TheCell/Weatherstation/README.md

# Weatherstation
A weather station we design from scratch

For the schema we use Kicad

We meet weekly and we discuss everything and work on the files and ideas. I recap our meetings in form of a blog here: https://blog.thecell.eu/blog/tag/weather/
