TheCell/Weatherstation/_media/Blogposts/WeatherStation_4_FinishingWindprobeSchema.pdf

blog.thecell.eu

## Weather station: Finishing windprobe schema

Name *

### 2 minutes

On 14. December 2019 by TheCell


This Session we finalized the schematics for the windprobe. The Diagram shown is tested in kicad and the electrical connections are all good. We changed how the interruptors are handled and what gets managed by the Raspberry. The Signal Management works over a I²C bus now.

Weather station: Finishing windprobe schema | about:reader?url=https://blog.thecell.eu/blog/2019/12/14/weather-station-...

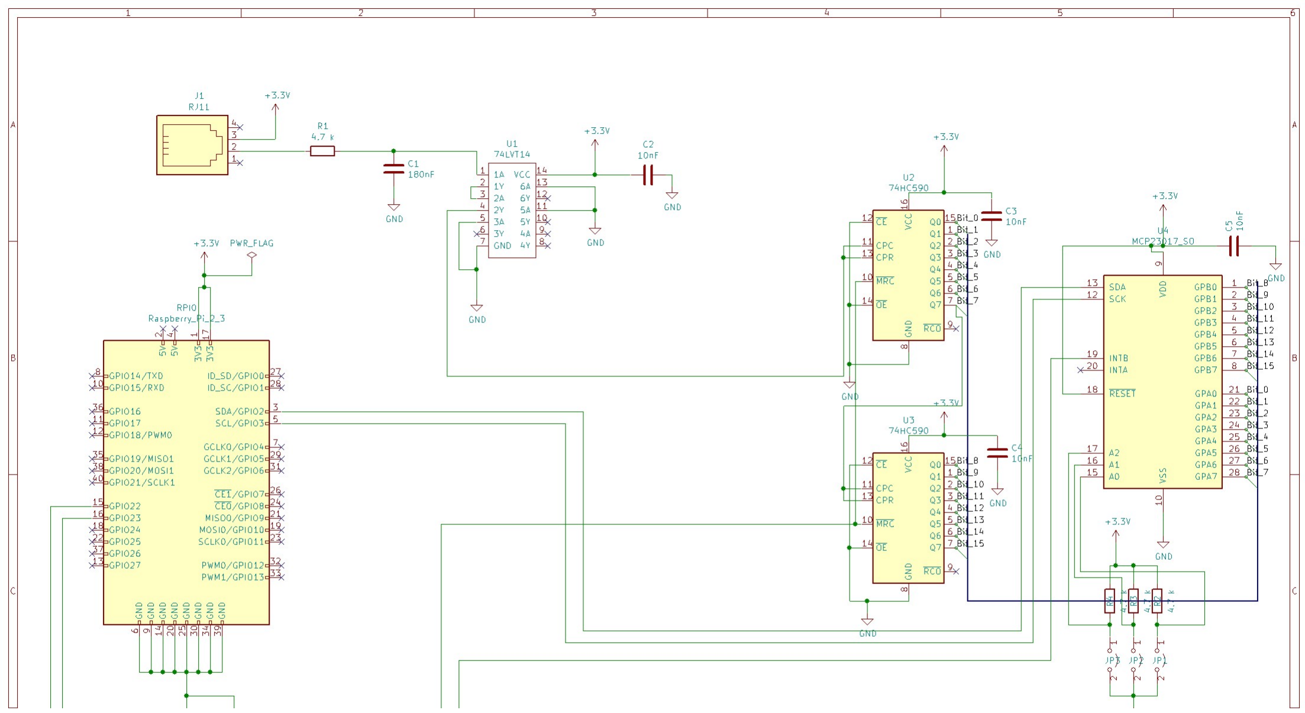
[picture p17: figure]

1 of 3 | 3/4/2020, 6:36 PM

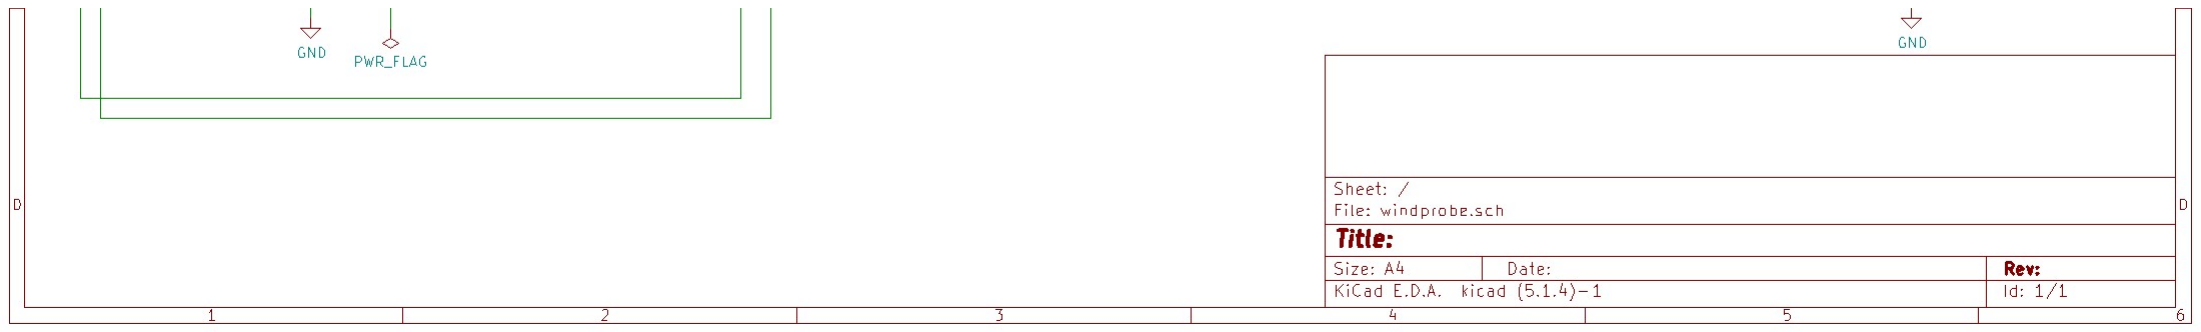
[picture p18: figure]

What is I²C and how does I²C work? I²C is a data bus protocol that allows us to have multiple probes communicating via I/O expander over the same line to the raspberry. More details can be found on Wikipedia. First of all, how do we know which I/O expander is sending the data

to the raspberry? We take a look at the MCP23017 Datasheet and we look at the A0 to A2 pins. The Datasheet (found in the github repo) on page 15 gives more details: Our Device has a 7 bit slave addressing. 4 fixed bits, 3 user-defined (A0 – A2). With these we can have multiple different I/O expander on the same line and identify every one of these separately. If you take a look at the bottom right of the schema, that’s why there are jumpers drawn there. When we set the jumper configuration differently on all I/O expanders on the same line we always know which device we are talking to.

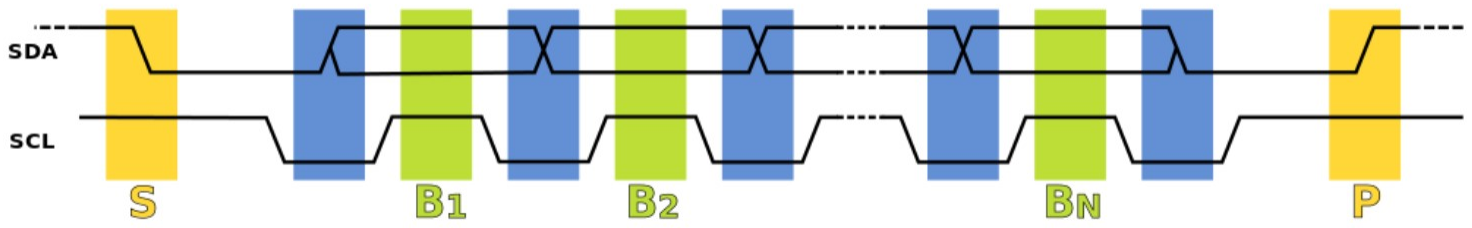
[picture p19: figure]

Now for the communication: How the communication works is very well explained in this video starting at 7 min 20 s. The embeded video should start at that time.

We will take a look at how everything is programmed later on when we have the parts and have everything working on a breadboard.

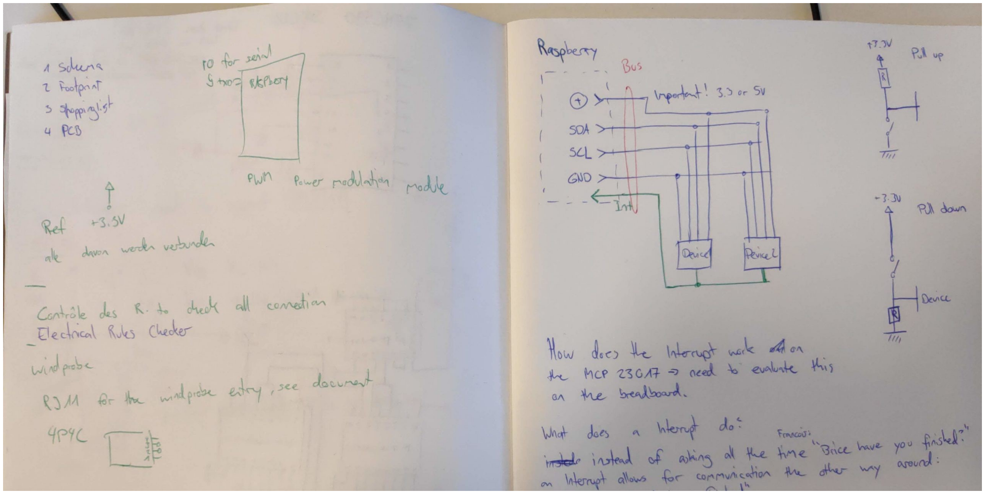
[picture p20: figure]

2 of 3 | 3/4/2020, 6:36 PM

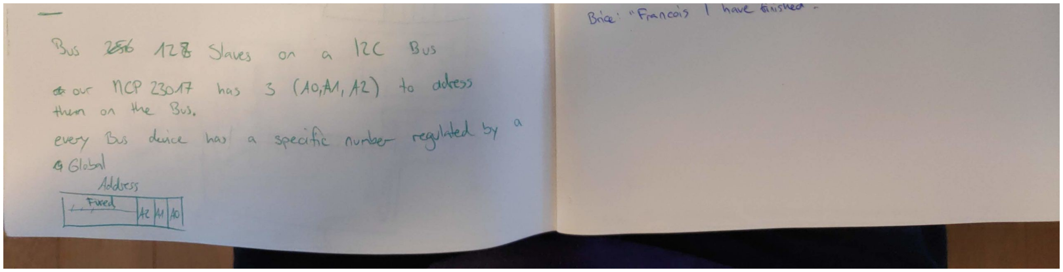
[picture p21: figure]

3 of 3 | 3/4/2020, 6:36 PM
