TheCell/Weatherstation/_media/windprobe_i2c/i2c_Before.PNG

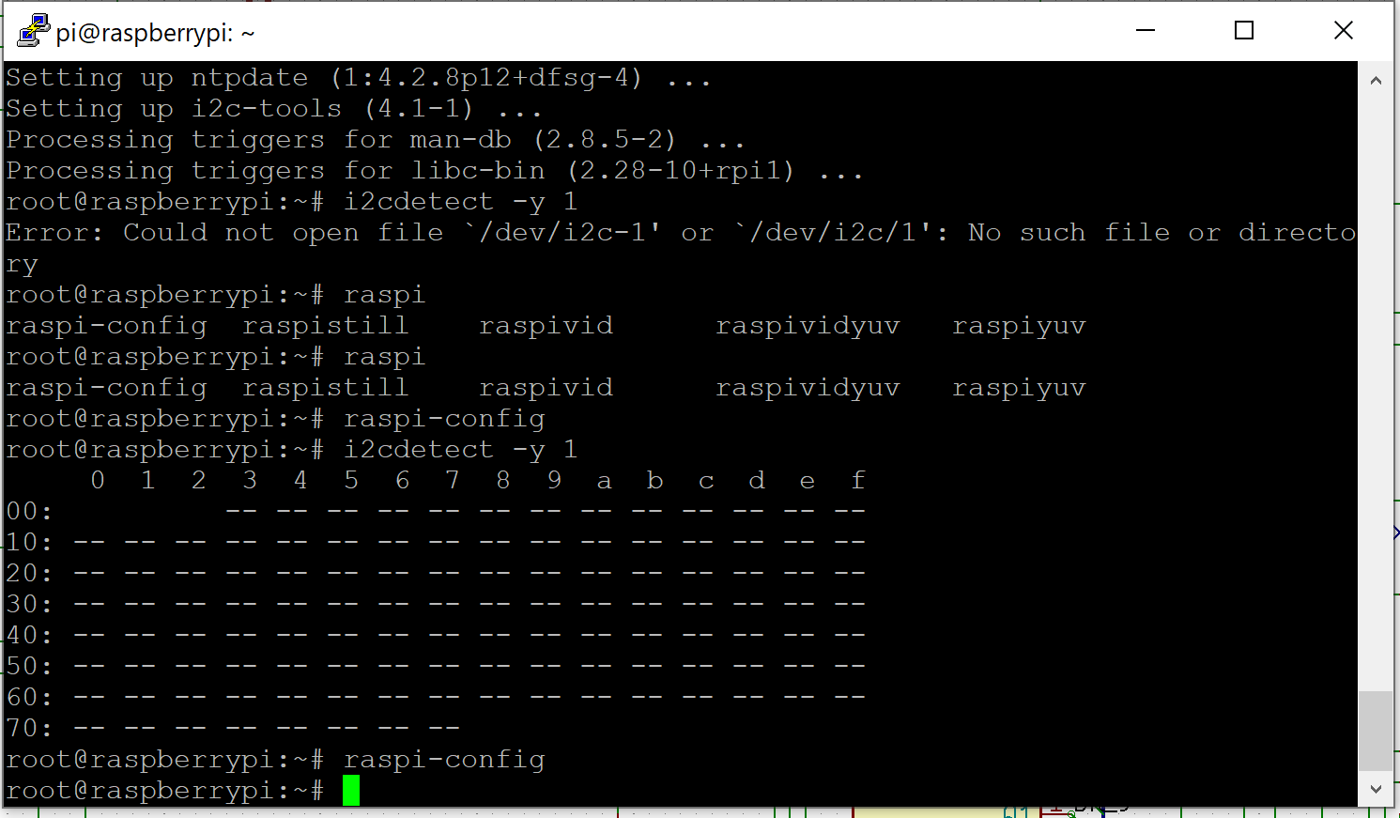
_media/windprobe_i2c/i2c_Before.PNG
