TheCell/Weatherstation/_media/windprobe_i2c/i2c_reading.PNG

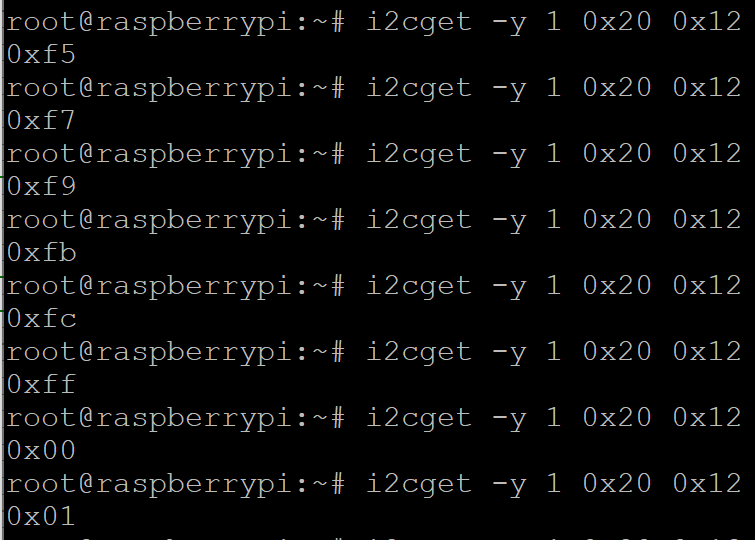
_media/windprobe_i2c/i2c_reading.PNG
