TheCell/Weatherstation/_media/windprobePartOfCircuit.PNG

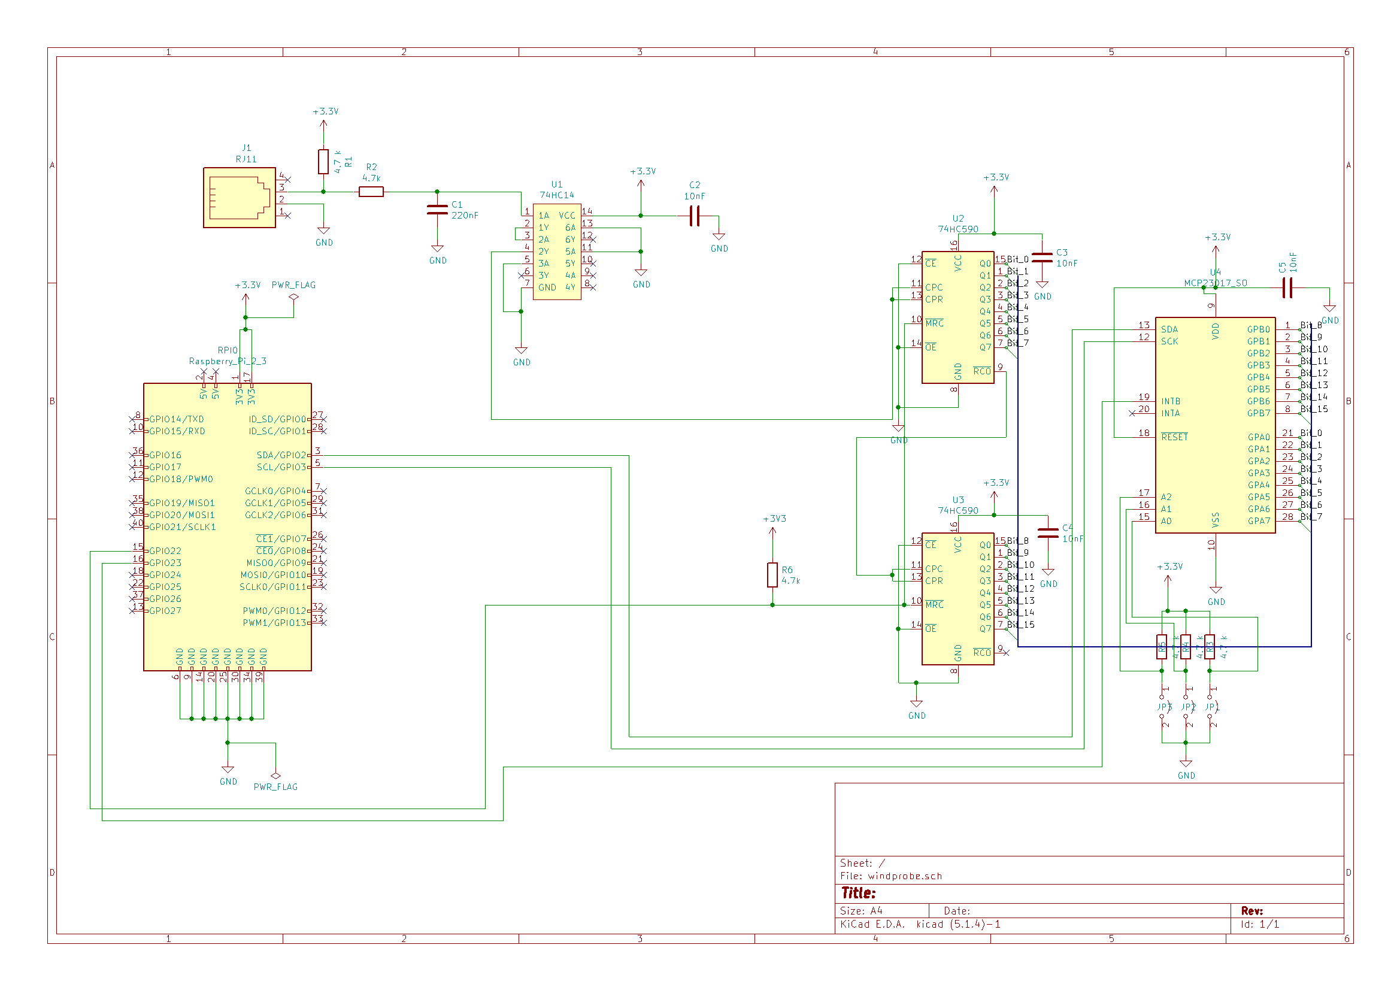
_media/windprobePartOfCircuit.PNG
