TheCell/Weatherstation/_media/Blogposts/WeatherStation_5_WindprobeShoppingList.pdf

blog.thecell.eu

## Weather station: Windprobe shopping list

Name *

### 2 minutes

On 14. December 2019 by TheCell

A complete list (we think) for the lab test components is under the meteo project folder (Test_Lab_Shopping_list.xlsx) and listed later in the blog. Also we had to change a capacitor value (from 180nf to 220nf) and the schmitt trigger because it is very hard to find these items. We updated the schema accordingly. We didn’t have time to go into detail how the mcp23017 interruptor works, thats up for the next time. But it looks very promising that the mcp23017 i/o expander is as customizable as we want it.

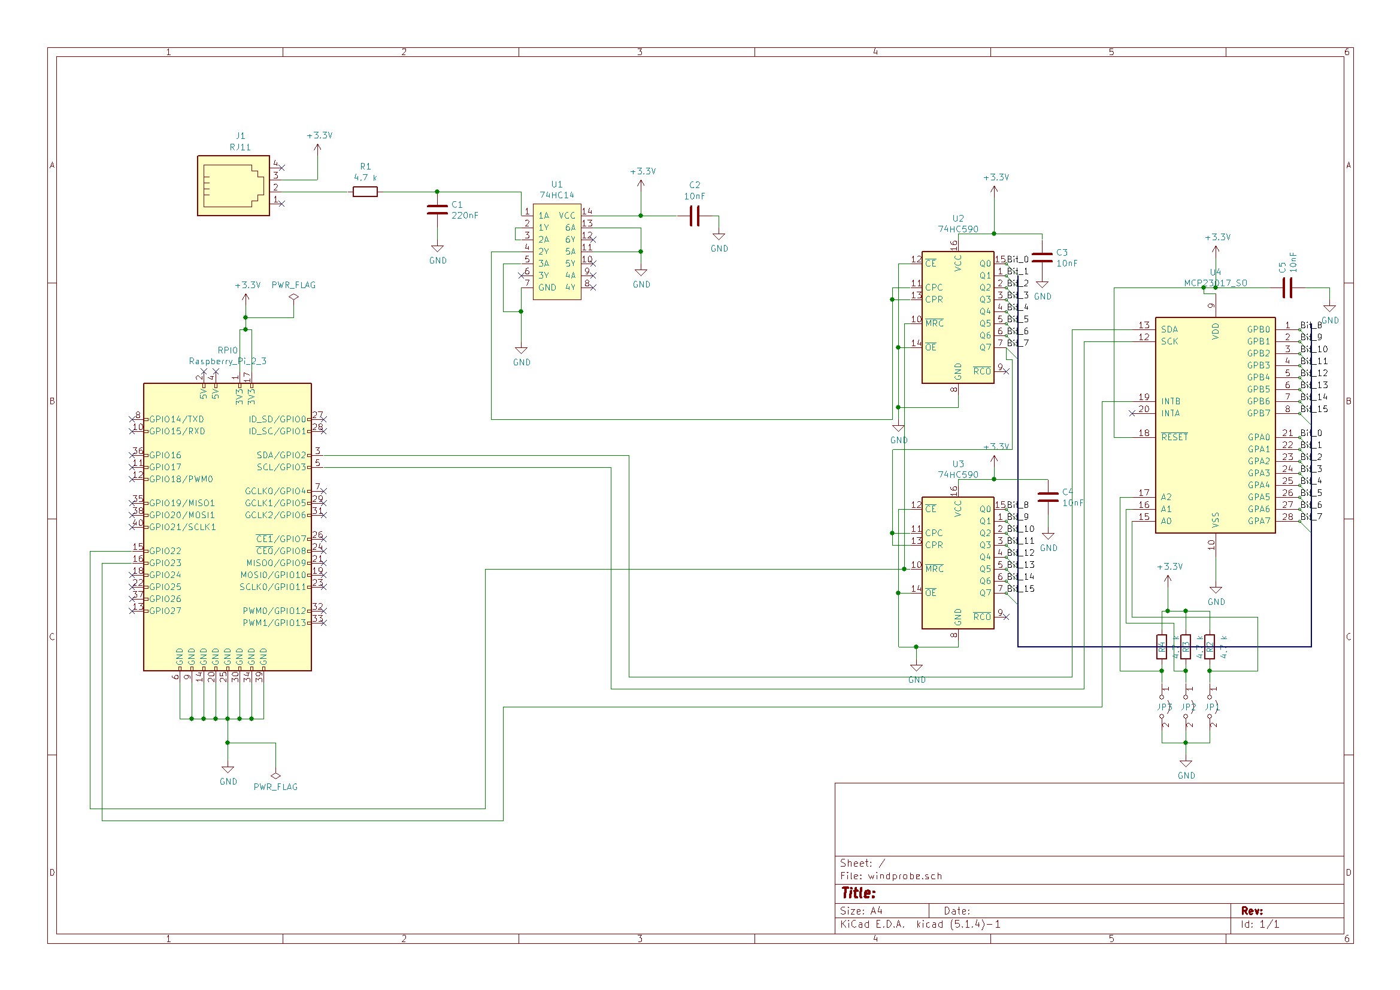
[picture p28: figure]

Here is a first shopping list. It’s important to note that it is a mix of windprobe specific items, project specific, general tools and test setup. If everything works out as planned I will create a project only shopping list with the exact parts needed.

Weather station: Windprobe shopping list | about:reader?url=https://blog.thecell.eu/blog/2019/12/14/weather-station...
1 of 2 | 3/4/2020, 6:37 PM

Windprobe specific (mostly)

Meteo station 68€

74HC14 7.40€

Serie E24 Resistors 2x 14.62€

Ceramic Capacitors 12€

Serie E24 Capacitors 19€

74HC590 10x 0.8€

MCP23017 18.81€

RJ45-Breakout 10.2€

General items or tools for either testing or for the entire station.

Labtest connectors 7€

Dupont Connector kit 37€

Labtest Board 30.8€

Lab test raspberry breakout 7€

POE Switch 40€

RPI-4 starter kit 105€

RPI-POE 18.4€

Labtest connectors 7€

As always, the Github is here: https://github.com/TheCell/Weatherstation

Weather station: Windprobe shopping list | about:reader?url=https://blog.thecell.eu/blog/2019/12/14/weather-station...
2 of 2 | 3/4/2020, 6:37 PM
