TheCell/Weatherstation/Buylist/Windprobe_Test_Lab_Shopping_list.xlsx

Designation | qty | PN | U Price | Price | Comment
Meteo station | 1 | https://www.gotronic.fr/art-capteurs-meteo-21542.htm | 89.90 € | 89.90 €
74HC14 | 10 | https://www.gotronic.fr/art-74hc14-10015.htm | 0.4 | 4.00 € | DIL Package for lab tests
Serie E24 Resistors | 2 | https://www.amazon.fr/R%C3%A9sistance-Assortiment-400-pi%C3%A8ces-r%C3%A9sistances-20-standard/dp/B07CQFWVJL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 | 14.63 | 29.26 € | 10 resistors per value full E24 serie
Ceramic Capacitors | 1 | https://www.amazon.fr/BOJACK-condensateurs-monolithiques-c%C3%A9ramique-Capacit%C3%A9/dp/B07PP7SFY8 | 11.99 | 11.99 € | Unpolarized capacitor low valur
Serie E24 Capacitors | 1 | https://www.amazon.fr/Wandefol-Condensateur-Electrolytique-Rangement-Valeurs/dp/B07Q6PNB6H/ | 15.95 | 15.95 € | Polarized capacitor high capacity
74HC590 | 10 | https://www.gotronic.fr/art-74hc590-10100.htm | 0.8 | 8.00 € | DIL Package for lab tests
MCP23017 | 1 | https://www.amazon.fr/Pi%C3%A8ces-MCP23017-Expander-compatible-Arduino/dp/B00P12065Q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 | 18.81 | 18.81 € | DIL Package for lab tests
RPI-4 | 1 | https://www.gotronic.fr/art-kit-raspberry-pi-4-b-kit-pi4-4gb-30856.htm | 104.9 | 104.90 € | Starter kit
RPI-POE | 1 | https://www.gotronic.fr/art-module-poe-pour-raspberry-pi3-b-ada3848-29026.htm | 18.4 | 18.40 €
POE Switch | 1 | https://www.amazon.fr/PS504-Switch-Power-Ethernet-802-3af/dp/B071DK16B2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 | 39.99 | 39.99 €
Dupont Connector kit | 1 | https://www.amazon.fr/Preciva-Sertissage-Sertisseuse-Connecteurs-Connecteur/dp/B07QY7K5SW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 | 36.99 | 36.99 €
Labtest connectors | 1 | https://www.amazon.fr/Elegoo-Breadboard-Femelle-Longueur-Arduino/dp/B01JD5WCG2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 | 6.99 | 6.99 €
Labtest Board | 1 | https://www.amazon.fr/BeMatik-dessais-l%C3%A9lectronique-Planche-prototypage/dp/B07JHKYWTZ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 | 30.79 | 30.79 €
Raspberry breakout | 1 | https://www.amazon.fr/Pi-EzConnect-Connecteur-Raspberry-connecter-Pi-3/dp/B01FE9EQ88 | 29 | 29.00 €
Lab test raspberry breakout | 1 | https://www.amazon.fr/DollaTek-Carte-dextension-Breakout-Raspberry/dp/B07DK4XDLW | 6.99 | 6.99 €
RJ45-Breakout | 1 | https://www.amazon.fr/Electronics-Salon-blind%C3%A9-Breakout-Terminal-connecteur/dp/B00U2DZOTM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 | 10.2 | 10.20 €
 |  |  | Total | 462.16 €
