TheCell/Weatherstation/_media/Blogposts/WeatherStation_6_FirstPhysicalTest.pdf

blog.thecell.eu

## Weather station: First Physical test

Name *

3-4 minutes

On 5. February 2020 by TheCell

Hello everyone. It’s been a while and Christmas, holidays and people having time off comes to a conclusion. This post is all about getting our hands on the ordered material and testing parts of our circuit for the first time. We already found an error in our schema with how the windprobe is included. I changed it to reflect our corrected test setup. The additional resistor (R2) is needed to not short out the Capacitor from the filtering stage every time the probe closes the circuit.

Weather station: First Physical test | about:reader?url=https://blog.thecell.eu/blog/2020/02/05/weather-station-...

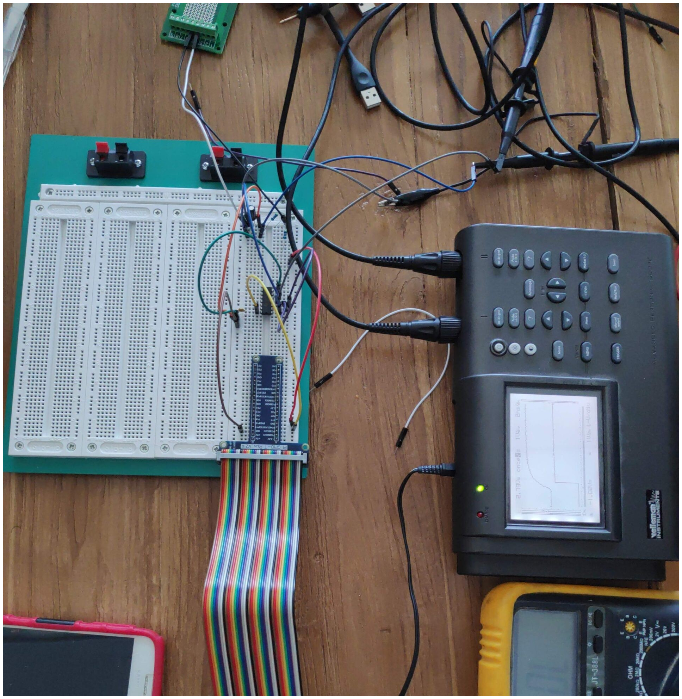
[picture p37: figure]

1 of 5 | 3/4/2020, 6:38 PM

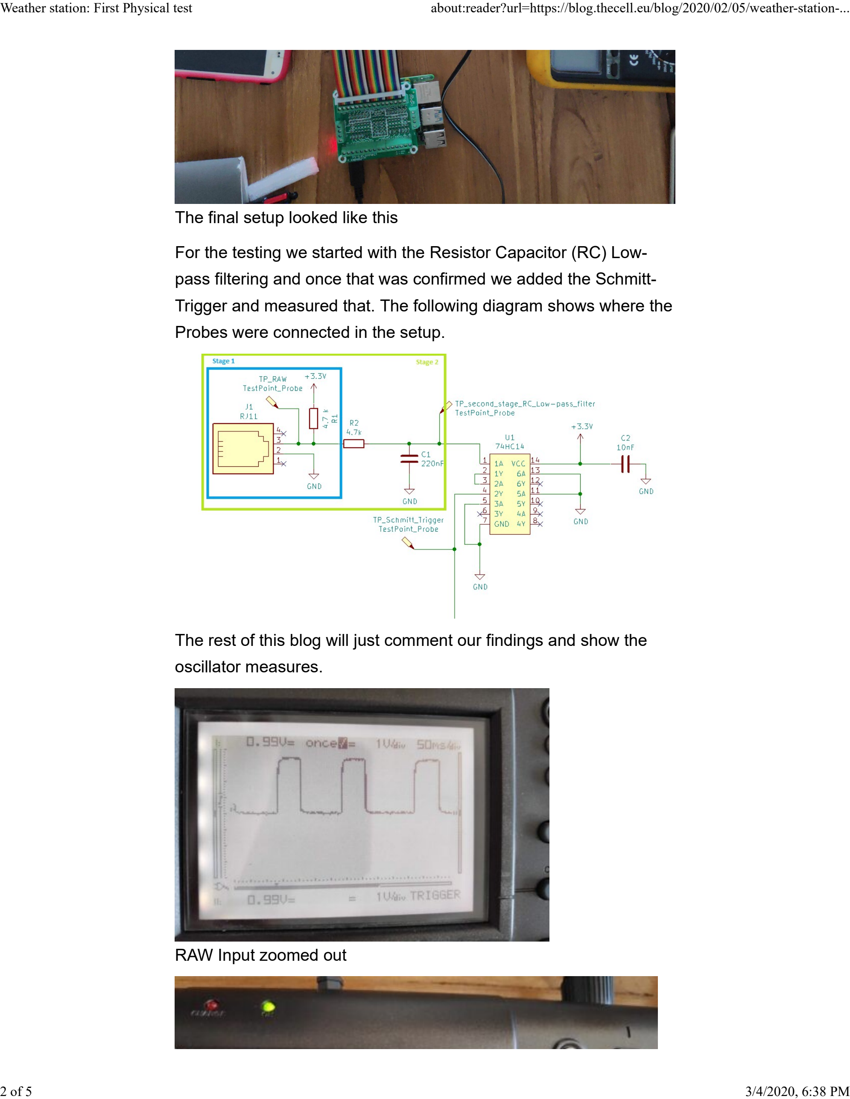
[picture p38: page 2]

The final setup looked like this

For the testing we started with the Resistor Capacitor (RC) Low-pass filtering and once that was confirmed we added the Schmitt-Trigger and measured that. The following diagram shows where the Probes were connected in the setup.

The rest of this blog will just comment our findings and show the oscillator measures.

RAW Input zoomed out

2 of 5 | 3/4/2020, 6:38 PM

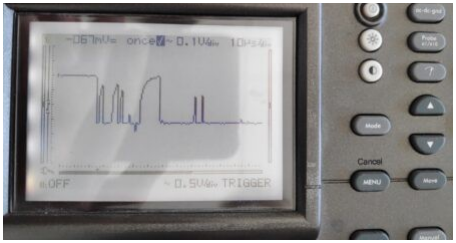
[picture p39: figure]

RAW Input zoomed in

Here we can see a zoom in on the raw input. When the probe is closed the circuit is grounded resulting in a tension fall off. What we can see here is, that the voltage drops but has some noise before it finally reaches zero. In fact with this signal we would already count ~7 rotations instead of 1.

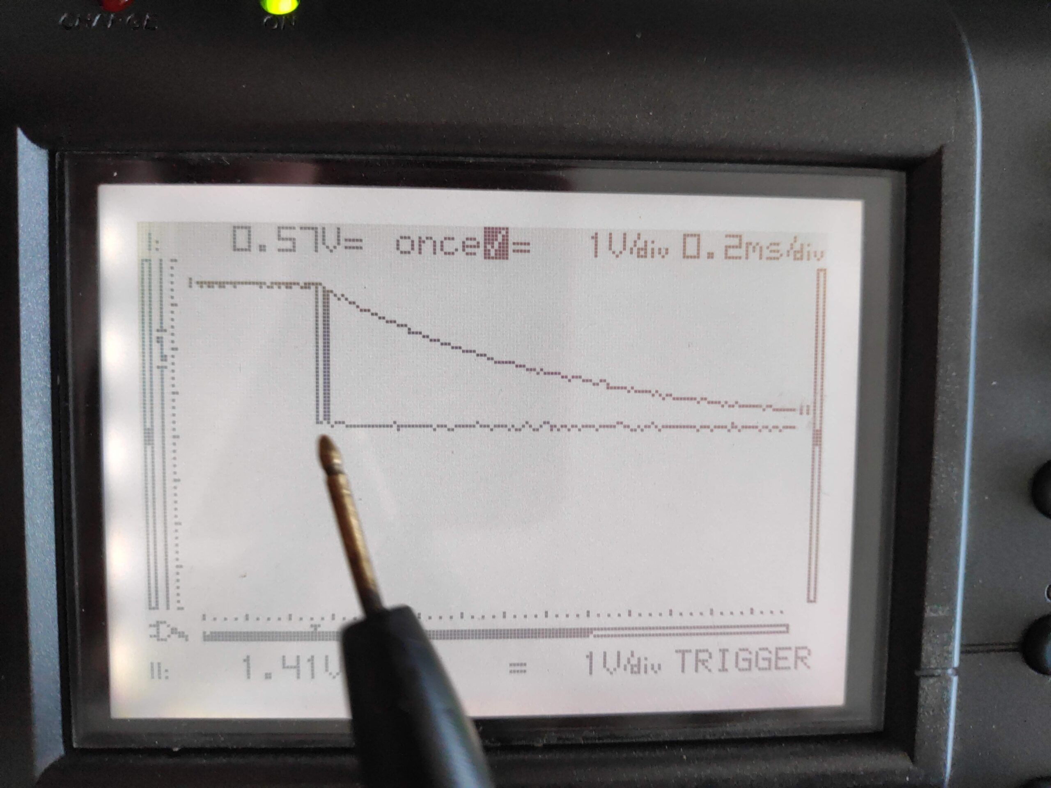
[picture p40: figure]

RAW Input vs Second Stage RC Low-pass filtered

Here you can see 2 probe measures on top of each other. The falling edge as RAW has some noise and the measure after the Second Stage RC Low-pass filter stage (the capacitor) which is gradually lowering the voltage without much noise. That’s a good sign already but we want a sharp and certain off to have multiple

3 of 5 | 3/4/2020, 6:38 PM

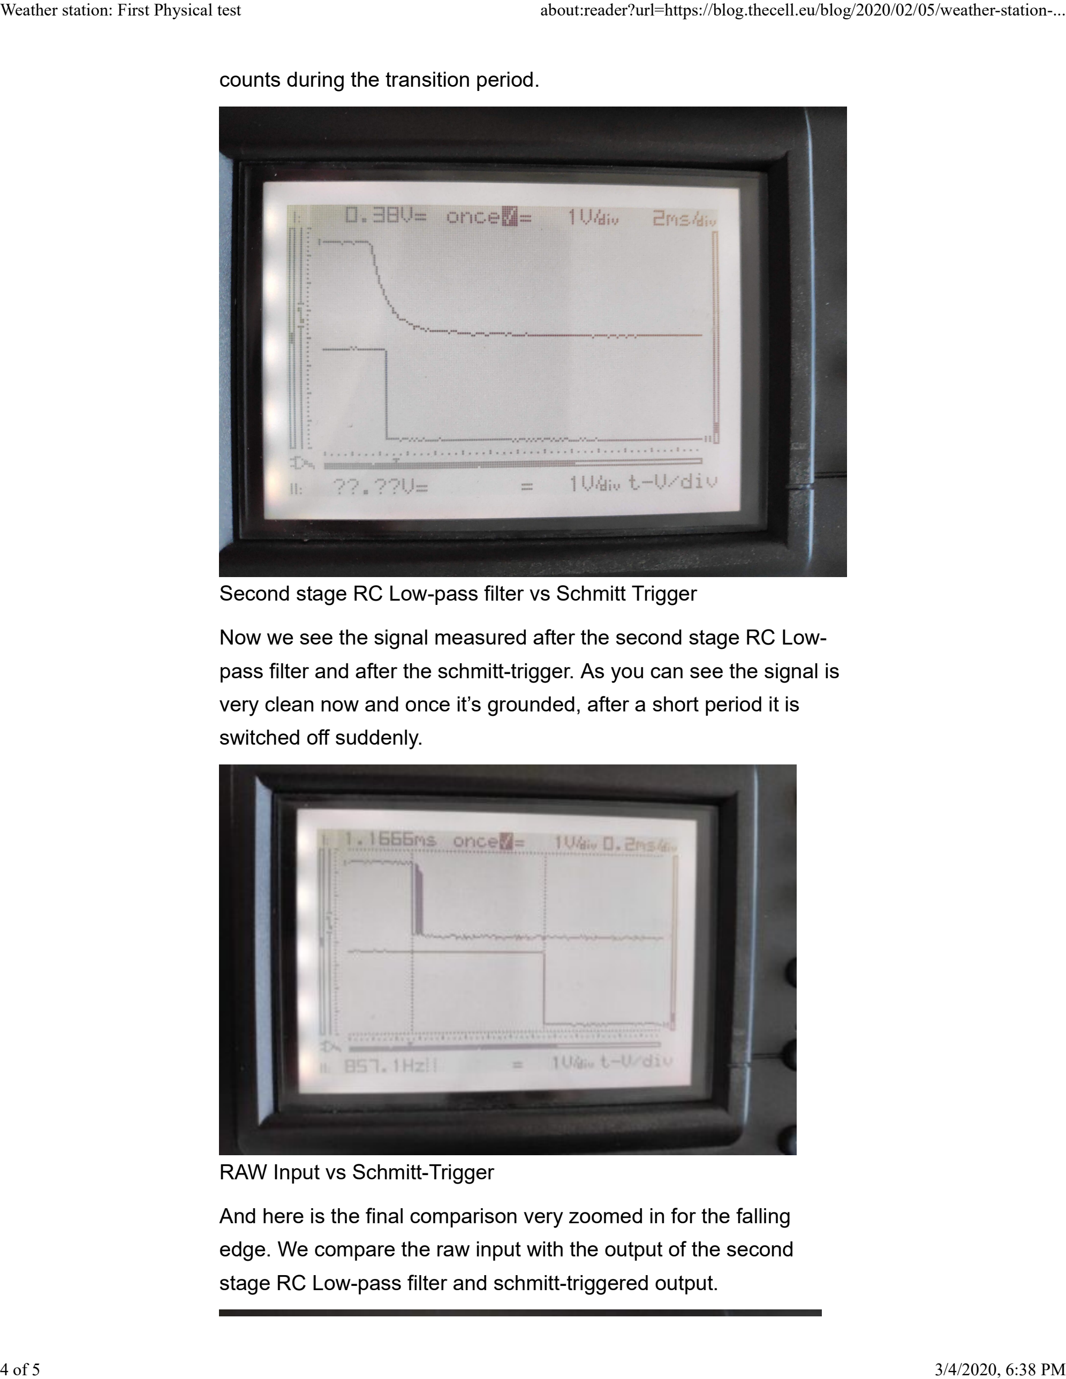
[picture p41: page 4]

counts during the transition period.

Second stage RC Low-pass filter vs Schmitt Trigger

Now we see the signal measured after the second stage RC Low-pass filter and after the schmitt-trigger. As you can see the signal is very clean now and once it’s grounded, after a short period it is switched off suddenly.

RAW Input vs Schmitt-Trigger

And here is the final comparison very zoomed in for the falling edge. We compare the raw input with the output of the second stage RC Low-pass filter and schmitt-triggered output.

4 of 5 | 3/4/2020, 6:38 PM

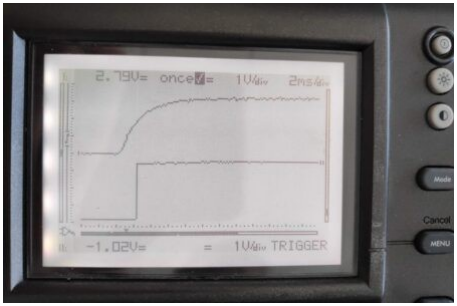
[picture p42: figure]

Second stage RC Low-pass filter vs Schmitt-Trigger

And at last here is an image of the rising edge after the second stage RC Low-pass filter and after the schmitt-trigger for completeness.

We are very satisfied with the setup of the windprobe, next time we will continue integrating more of the circuit to confirm the counters work like we planned them to work.

Github Link: https://github.com/TheCell/Weatherstation

5 of 5 | 3/4/2020, 6:38 PM
