TheCell/Weatherstation/(commit log)

2019-11-26 added minimal kicad file
    [windprobe.kicad_pcb, windprobe.sch]
2019-11-26 started modelling the circuit
    [windprobe.sch]
2019-11-27 updated circuit
    [windprobe.sch]
2019-12-07 added connectors
    [windprobe.sch]
2019-12-10 updated schema and media
    [windprobe.sch]
2019-12-17 updated schematics. added buylist
    [Windprobe_Test_Lab_Shopping_list.xlsx, windprobe.sch]
2019-12-17 updated circuit and datasheet
2020-01-08 updated capacitors because they were out of stock
    [Windprobe_Test_Lab_Shopping_list.xlsx]
2020-02-05 updated error
    [windprobe.sch]
2020-02-05 updated schema
    [windprobe.sch]
2020-02-25 windprobe wired and working
    [windprobe.sch]
2020-03-04 updated schematics
    [windprobe.sch]
2020-03-10 took the inverter out
    [windprobe.sch]
2020-03-10 updated schematics image
